vectorstofinal/millz-a10-simpit/public/img/aux-lts-first-light.jpg

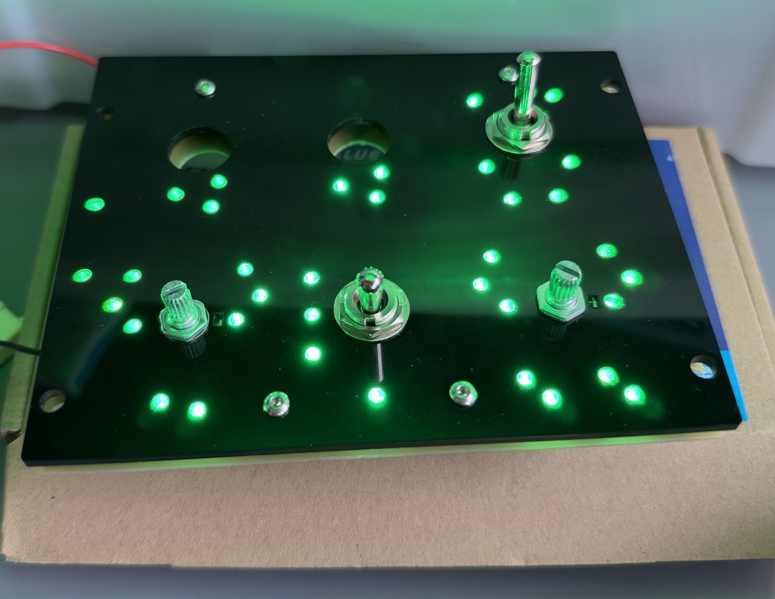
public/img/aux-lts-first-light.jpg
