vectorstofinal/millz-a10-simpit/public/img/aux-lts-lit-panel.jpg

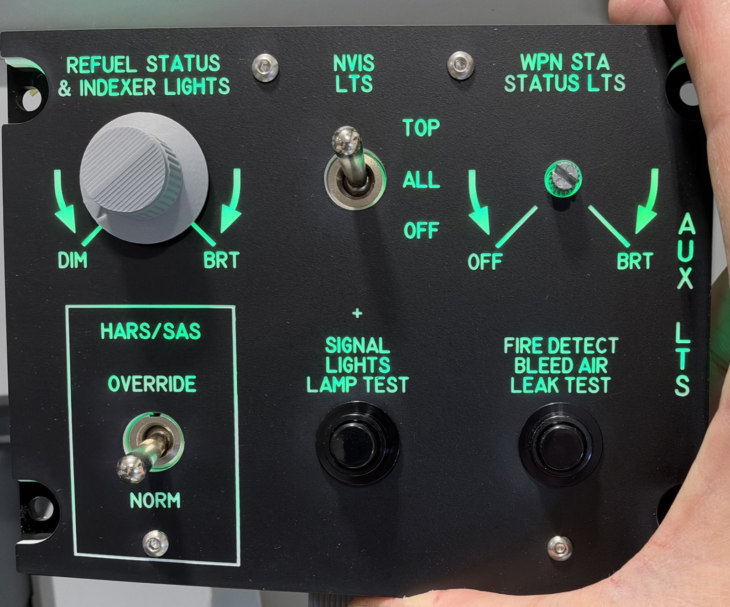
public/img/aux-lts-lit-panel.jpg
