vectorstofinal/millz-a10-simpit/src/pages/about.md

---
layout: ../layouts/Page.astro
title: About
eyebrow: The pit, the shop, the fine print
description: About the Millz A-10 SimPit build, plus credits and licensing.
---

I'm J. I run **millz**, a small maker shop with an aviation streak: CNC routing, laser cutting, 3D printing and small electronics. This site is the build log for my replica **A-10C Warthog** cockpit for DCS World.

## The shop

- **CNC router:** Onefinity Elite Foreman (Gen 2), 4x4 bed, Redline controller, 80 mm air-cooled spindle, VCarve Pro
- **Laser:** Thunder Laser Bolt Pro 36 (80 W RF CO2), LightBurn
- **3D printer:** Prusa XL, 0.4 mm nozzle, mostly PETG
- **CAD:** FreeCAD and OpenSCAD

More detail, and what each machine does in the build: [equipment](/equipment/).

## Licensing

- **My original work** (posts, settings, test results, board designs, STLs, OpenSCAD source, sketches) is dedicated to the public domain under [CC0 1.0](https://creativecommons.org/publicdomain/zero/1.0/). Use it however you like.
- **Panel files** are edits of The Warthog Project's free release. Their author says: *"I have no interest in claiming copyright on my own work… I am releasing these files to the public, do with them what you will."* I'm passing them on the same way, with credit.
- **Everything else** on the credits list belongs to its owners. I link to it rather than host it.

No warranty. Lasers, routers, mains power and ATX supplies can hurt you. Measure your own parts.

## Credits

- **[The Warthog Project](https://thewarthogproject.com):** the panel designs everything here starts from, and the best A-10C pit resource out there. [YouTube](https://www.youtube.com/channel/UCJq3cq9N6xYF0fAvTgpwoBg/).
- **FLIM / Vr-pits:** the cockpit structure plans (seat, consoles, glare shield). Paid plans, not redistributed here. See the [Vr-pits plans thread](https://forum.dcs.world/topic/123000-vrpitscom-cockpit-plans-for-sale) on the DCS forums.
- **[DCS-BIOS](https://github.com/DCS-Skunkworks/dcs-bios)** and **[Bort](https://github.com/DCS-Skunkworks/Bort)** by DCS-Skunkworks: how the pit talks to the sim.
- **Les Green:** printable A-10C parts on [GrabCAD](https://grabcad.com/les.green-2/models) ([forum thread](https://forum.dcs.world/topic/337352-miscellaneous-3d-files-a10c-parts)). Get them from him.
- **MS33558 font** by Derek Higgs (corrected 2020 by hsssonic). Freely available online; not hosted here.
- **[Houston Acrylic](https://houstonacrylic.com):** the acrylic in every panel.
- **[Eagle Dynamics](https://www.digitalcombatsimulator.com):** DCS World and the A-10C module. Cockpit textures are theirs and aren't hosted here.
