vectorstofinal/millz-a10-simpit/public/img/aux-lts-3d.png

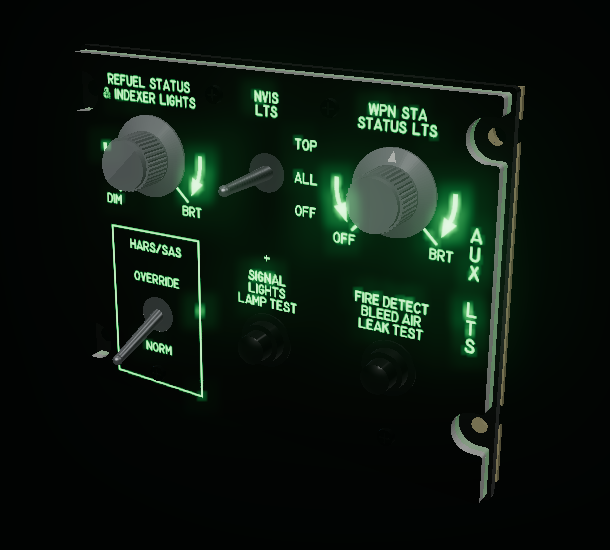
public/img/aux-lts-3d.png
