vectorstofinal/millz-a10-simpit/public/img/aux-lts-gnd-links.png

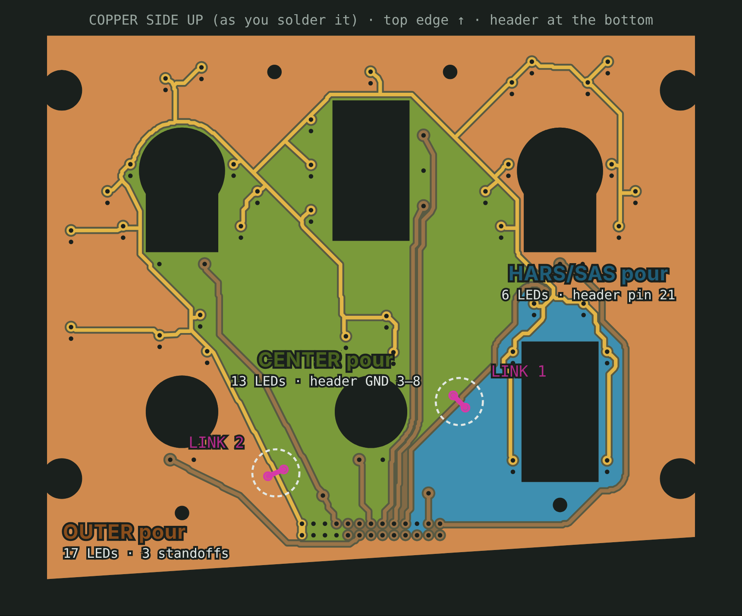
public/img/aux-lts-gnd-links.png
