vectorstofinal/millz-a10-simpit/public/img/aux-lts-gnd-staple.png

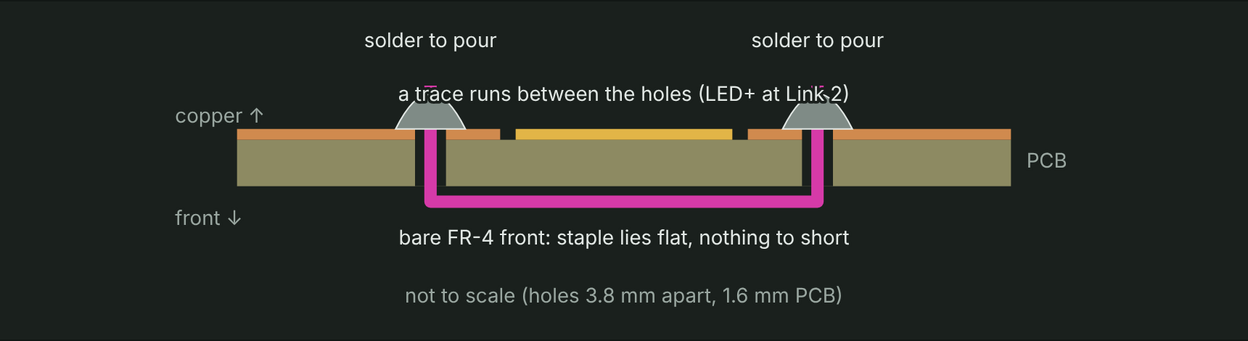
public/img/aux-lts-gnd-staple.png
