vectorstofinal/millz-a10-simpit/public/img/aux-lts-led-clearance.png

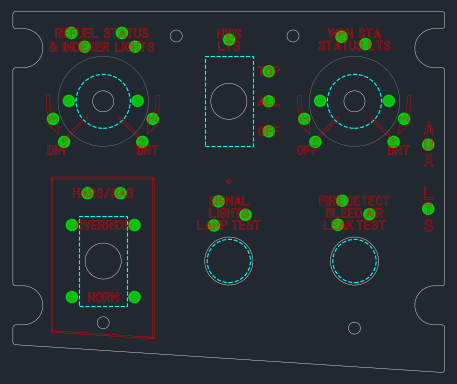
public/img/aux-lts-led-clearance.png
