vectorstofinal/millz-a10-simpit/public/img/aux-lts-led-seating.png

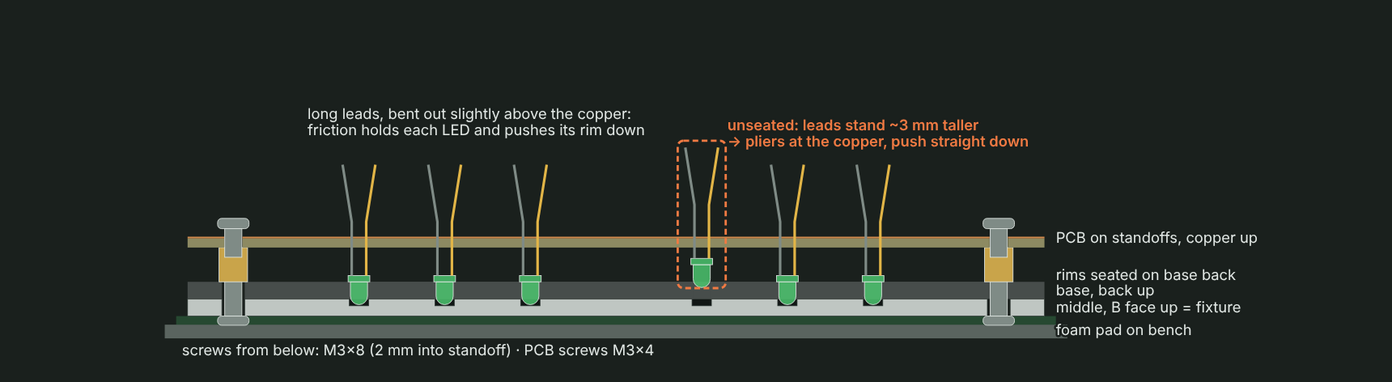
public/img/aux-lts-led-seating.png
