vectorstofinal/millz-a10-simpit/public/img/aux-lts-pcb-over-base.png

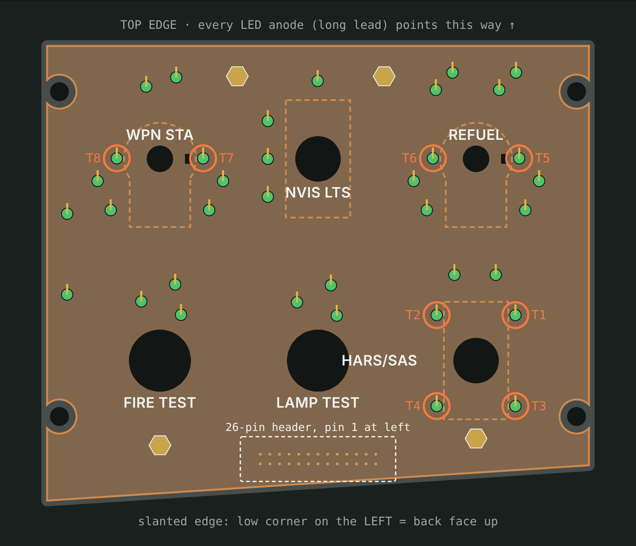
public/img/aux-lts-pcb-over-base.png
