vectorstofinal/millz-a10-simpit/public/img/aux-lts-pcb-v2-copper.png

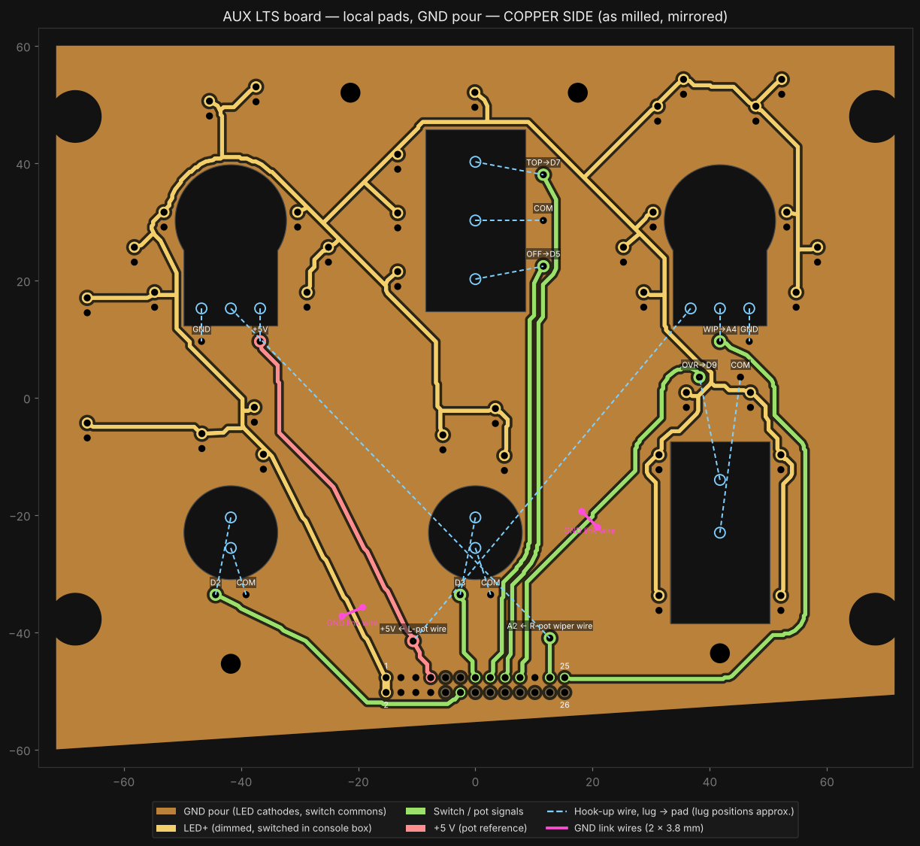
public/img/aux-lts-pcb-v2-copper.png
