vectorstofinal/millz-a10-simpit/public/img/aux-lts-pcb-v2-front.png

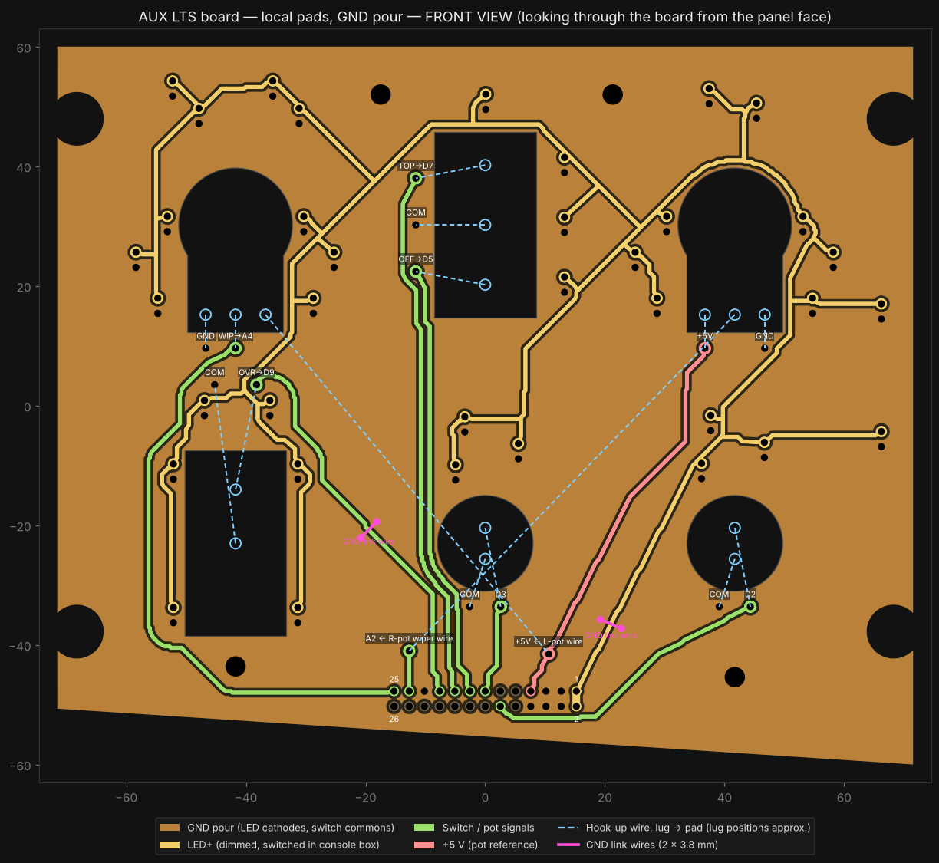
public/img/aux-lts-pcb-v2-front.png
