vectorstofinal/millz-a10-simpit/public/img/aux-lts-pcb-v2-vcarve-job.png

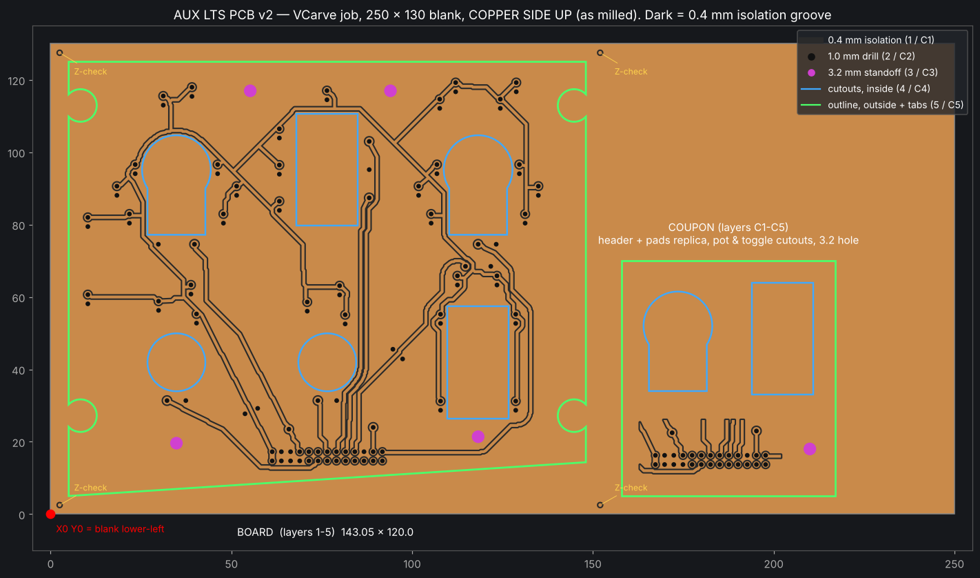
public/img/aux-lts-pcb-v2-vcarve-job.png
