vectorstofinal/millz-a10-simpit/public/img/aux-lts-stack-section.png

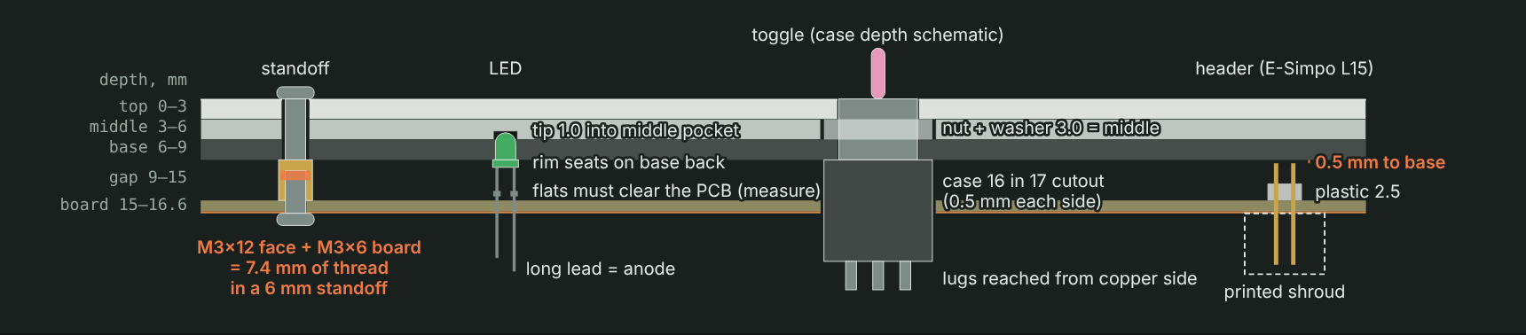
public/img/aux-lts-stack-section.png
