vectorstofinal/millz-a10-simpit/public/img/aux-lts-stacked-front.jpg

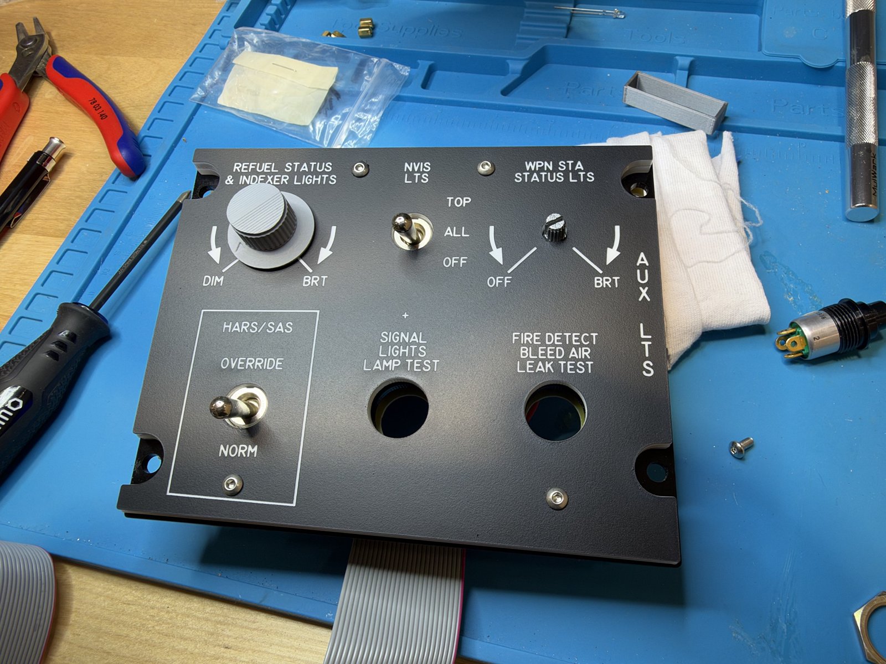
public/img/aux-lts-stacked-front.jpg
