vectorstofinal/millz-a10-simpit/public/img/aux-lts-terminals-back.jpg

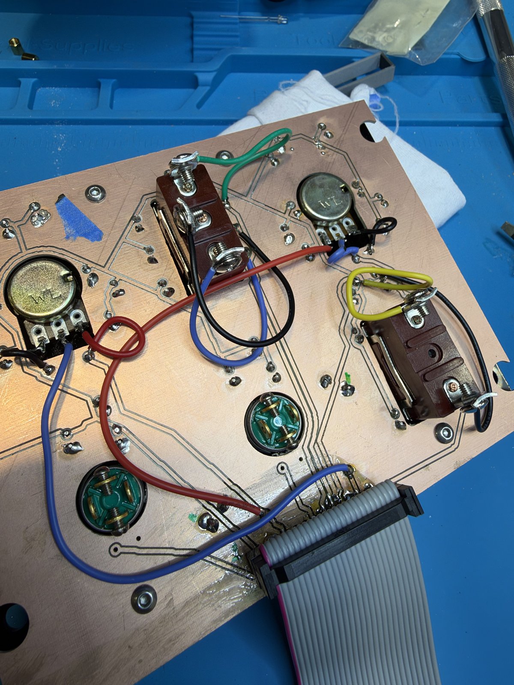
public/img/aux-lts-terminals-back.jpg
