vectorstofinal/millz-a10-simpit/public/img/aux-lts-top-preview.png

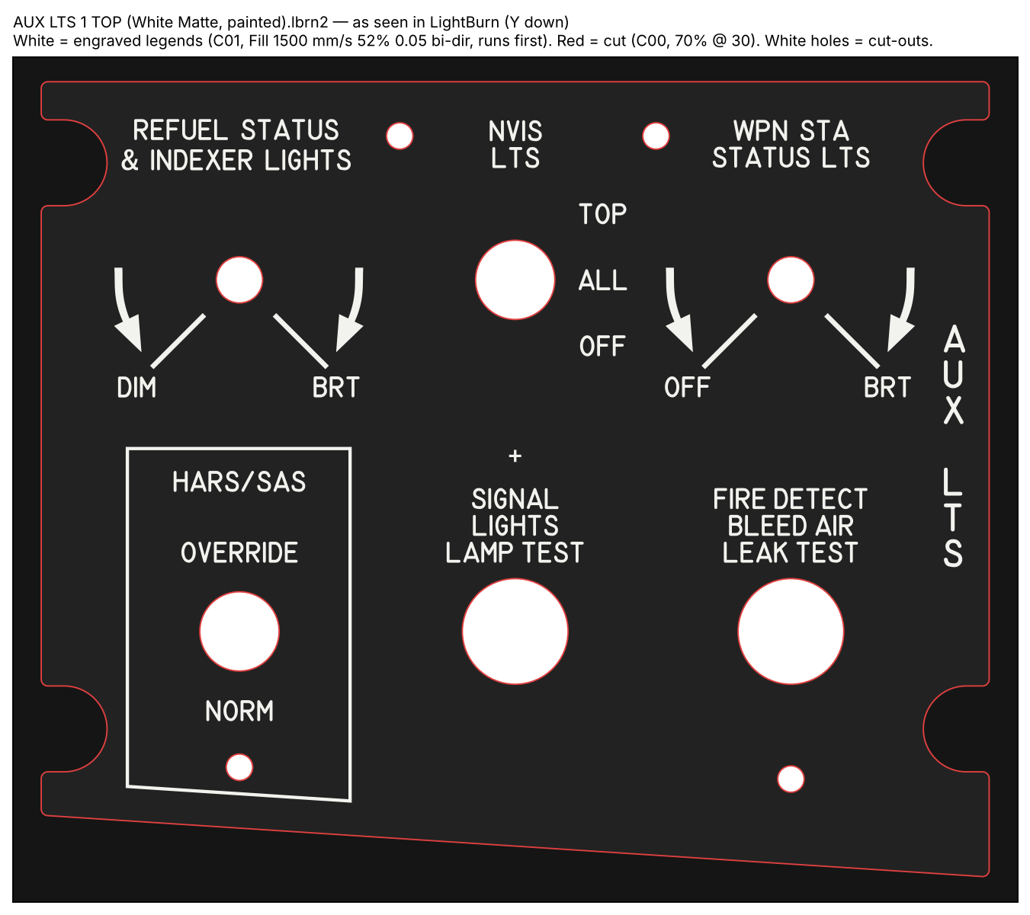
public/img/aux-lts-top-preview.png
