vectorstofinal/millz-a10-simpit/public/img/aux-lts-trimmed-back.jpg

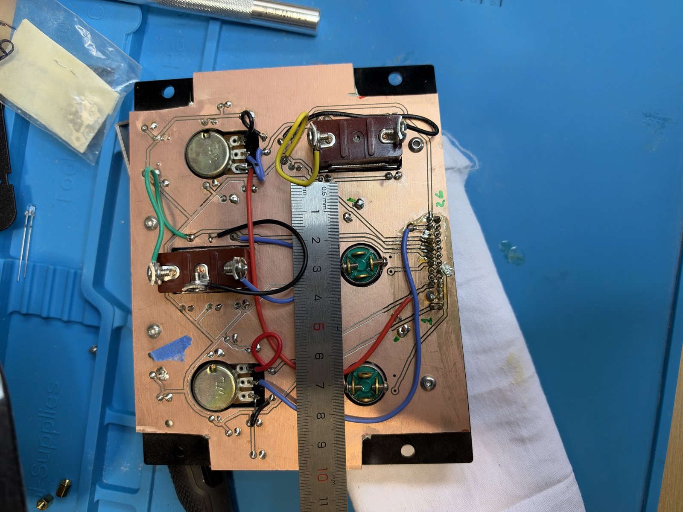
public/img/aux-lts-trimmed-back.jpg
