vectorstofinal/millz-a10-simpit/public/img/aux-lts-wired-back.jpg

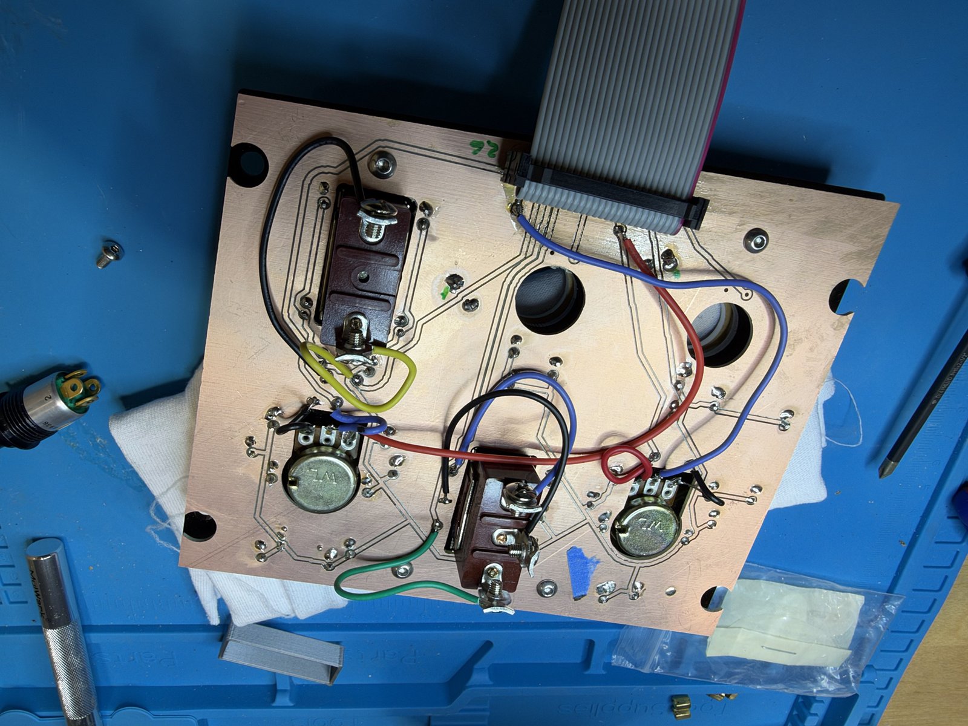
public/img/aux-lts-wired-back.jpg
