vectorstofinal/millz-a10-simpit/public/img/dimmer-knob-preview.png

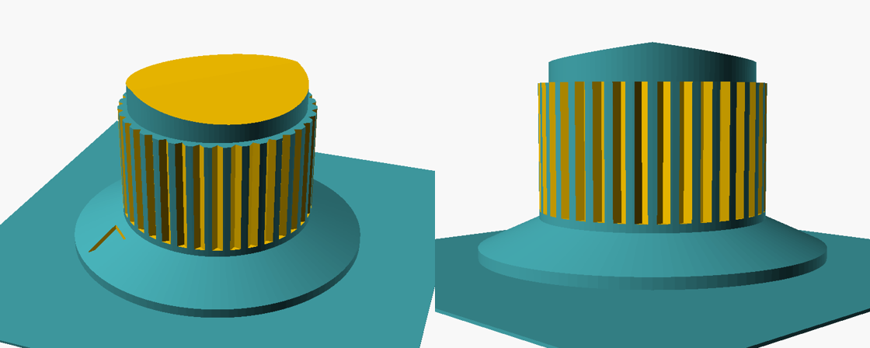
public/img/dimmer-knob-preview.png
