vectorstofinal/millz-a10-simpit/public/files/aux-lts-back-case/aux-lts-back-case-v2.stl

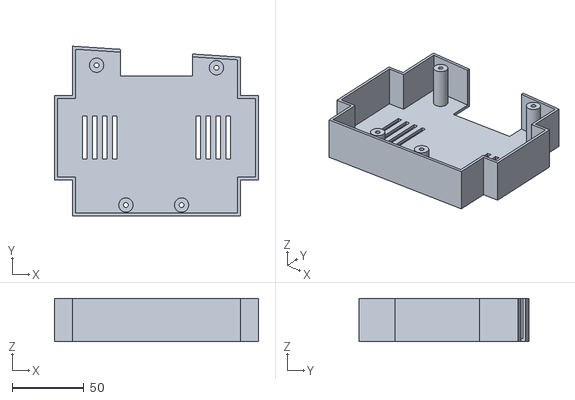
[picture p19: CAD file, 2026-11-14]
public/files/aux-lts-back-case/aux-lts-back-case-v2.stl
142.1 x 118.1 x 30.0
