vectorstofinal/millz-a10-simpit/public/files/aux-lts-panel/aux-lts-all-layers-edited.dxf

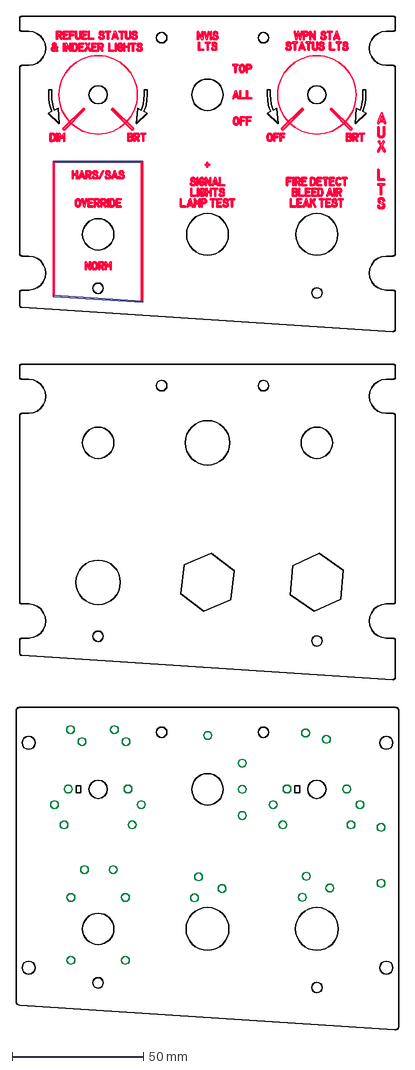
[picture p20: CAD file, 2026-11-11]
public/files/aux-lts-panel/aux-lts-all-layers-edited.dxf
146.1 x 386.7 mm
