vectorstofinal/millz-a10-simpit/public/files/aux-lts-pcb/header-pin-trim-gauge-8mm.stl

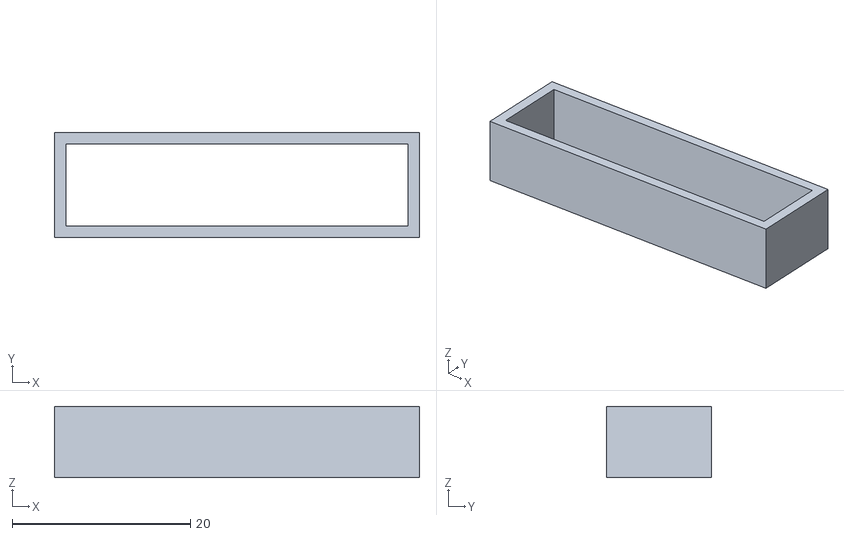
[picture p21: CAD file, 2026-11-13]
public/files/aux-lts-pcb/header-pin-trim-gauge-8mm.stl
41.0 x 11.8 x 8.00
