vectorstofinal/millz-a10-simpit/public/files/dimmer-knob/dimmer-knob-26mm.stl

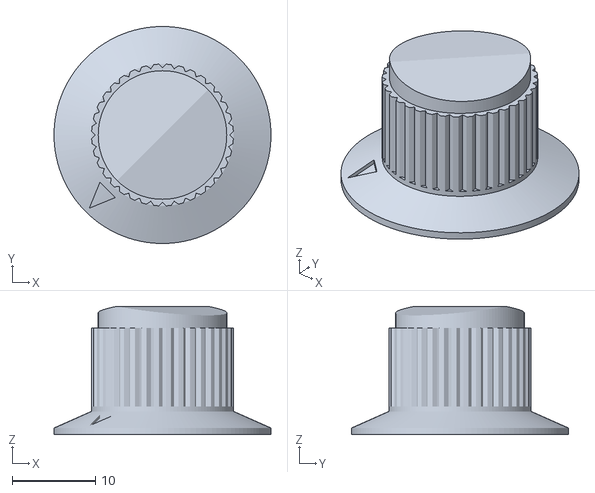
[picture p22: CAD file, 2026-11-11]
public/files/dimmer-knob/dimmer-knob-26mm.stl
26.0 x 26.0 x 15.4
