vectorstofinal/millz-a10-simpit/public/files/laser-tests/aux-lts-fit-test-strip.dxf

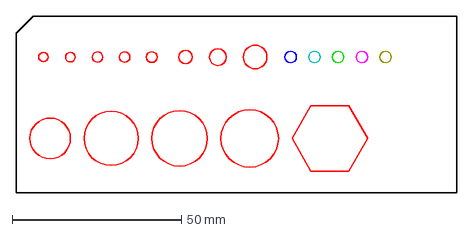
[picture p23: CAD file, 2026-11-11]
public/files/laser-tests/aux-lts-fit-test-strip.dxf
130.0 x 52.0 mm
