vectorstofinal/millz-a10-simpit/public/files/aux-lts-back-case/aux-lts-pcb-v2-trimmed-outline.dxf

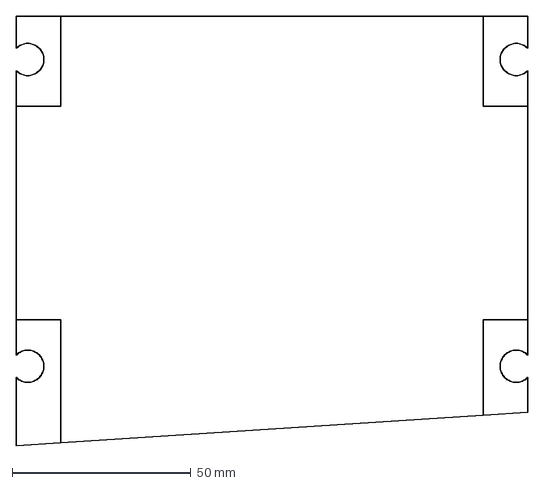
[picture p24: CAD file, 2026-11-14]
public/files/aux-lts-back-case/aux-lts-pcb-v2-trimmed-outline.dxf
143.1 x 120.0 mm
