vectorstofinal/millz-a10-simpit/public/files/aux-lts-panel/aux-lts-2-middle.dxf

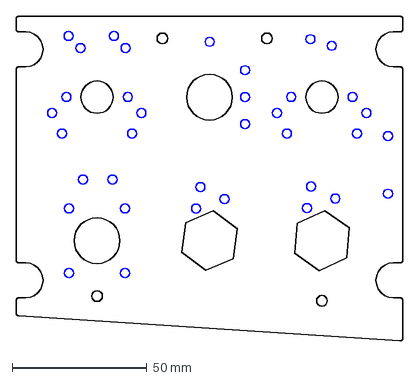
[picture p25: CAD file, 2026-11-11]
public/files/aux-lts-panel/aux-lts-2-middle.dxf
143.5 x 120.4 mm
