vectorstofinal/millz-a10-simpit/public/files/aux-lts-pcb/aux-lts-pcb-v2-vcarve-job-250x130.dxf

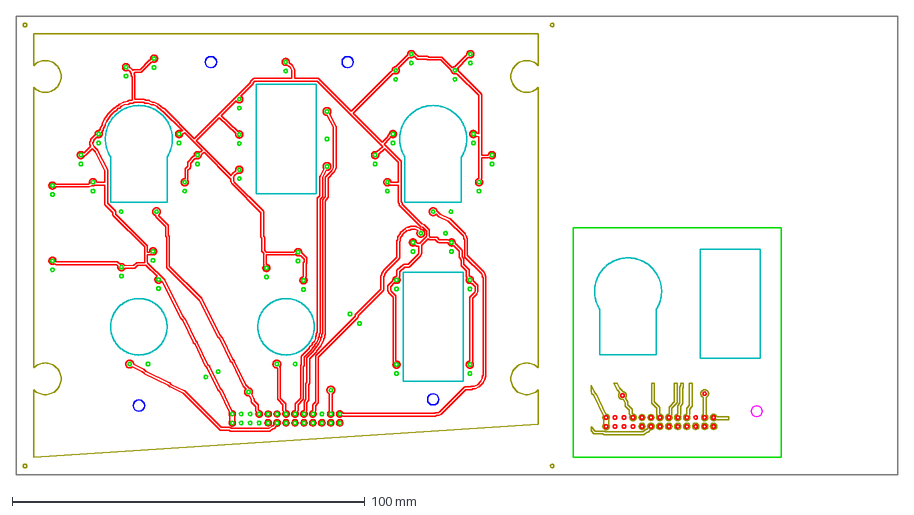
[picture p26: CAD file, 2026-11-11]
public/files/aux-lts-pcb/aux-lts-pcb-v2-vcarve-job-250x130.dxf
250.0 x 130.0 mm
