vectorstofinal/millz-a10-simpit/public/files/aux-lts-panel/aux-lts-3-base.dxf

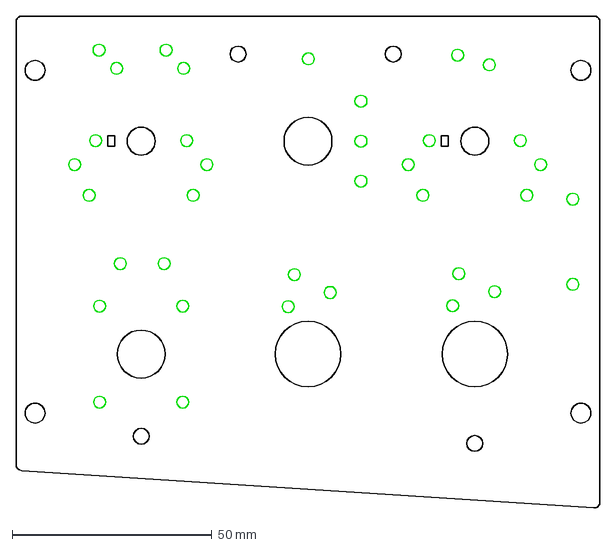
[picture p27: CAD file, 2026-11-11]
public/files/aux-lts-panel/aux-lts-3-base.dxf
146.1 x 123.0 mm
