vectorstofinal/millz-a10-simpit/public/files/aux-lts-pcb/aux-lts-pcb-v2-cnc-back-view.dxf

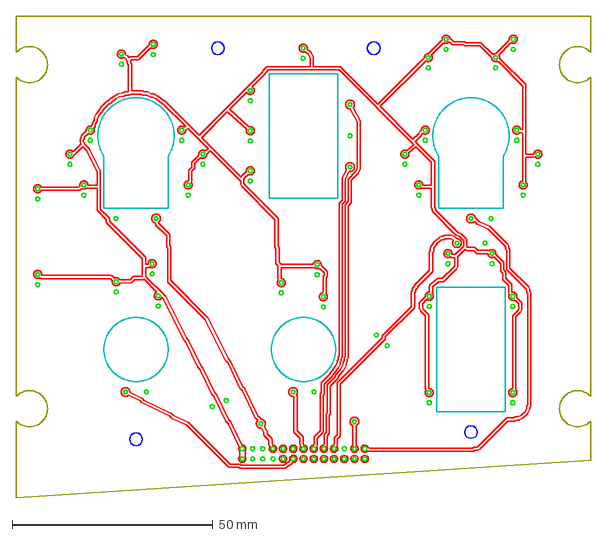
[picture p28: CAD file, 2026-11-11]
public/files/aux-lts-pcb/aux-lts-pcb-v2-cnc-back-view.dxf
143.1 x 120.0 mm
