vectorstofinal/millz-a10-simpit/public/files/aux-lts-panel/aux-lts-1-top.dxf

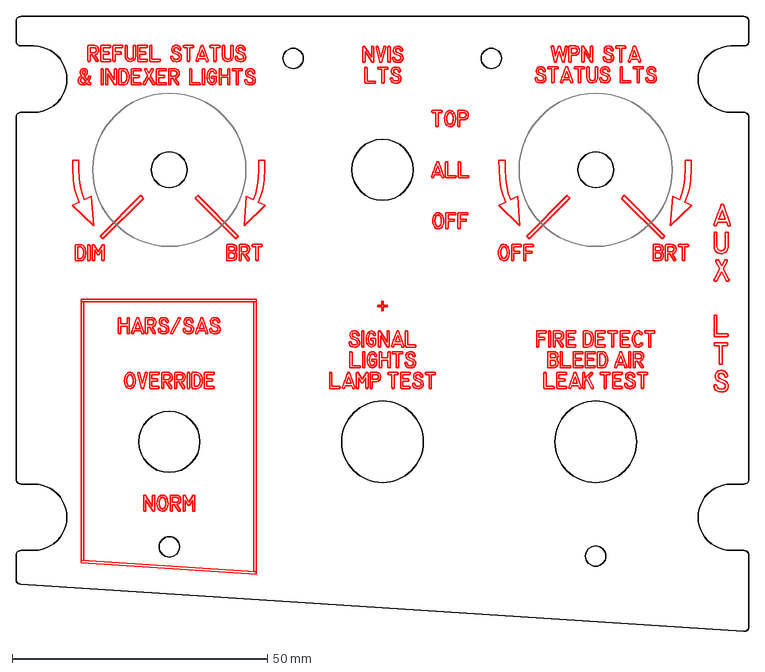
[picture p29: CAD file, 2026-11-11]
public/files/aux-lts-panel/aux-lts-1-top.dxf
143.5 x 120.4 mm
