vectorstofinal/millz-a10-simpit/public/files/aux-lts-pcb/idc-2x13-keyed-shroud.stl

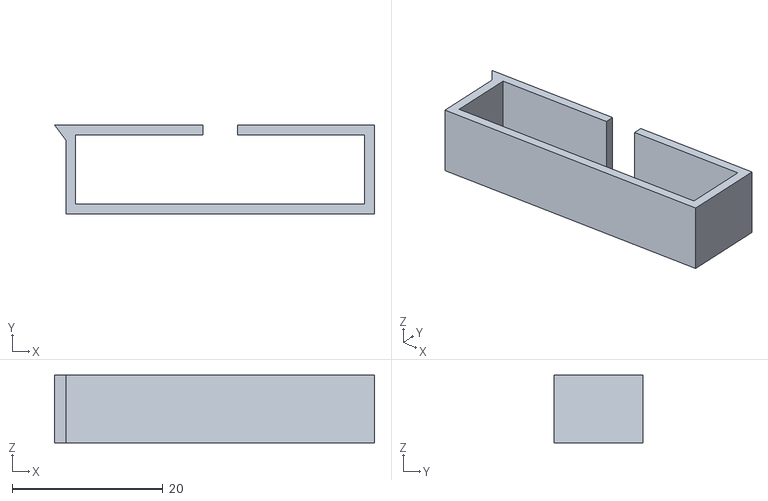
[picture p30: CAD file, 2026-11-11]
public/files/aux-lts-pcb/idc-2x13-keyed-shroud.stl
42.5 x 11.8 x 9.00
