vectorstofinal/millz-a10-simpit/public/img/aux-lts-bench-rig-wiring.png

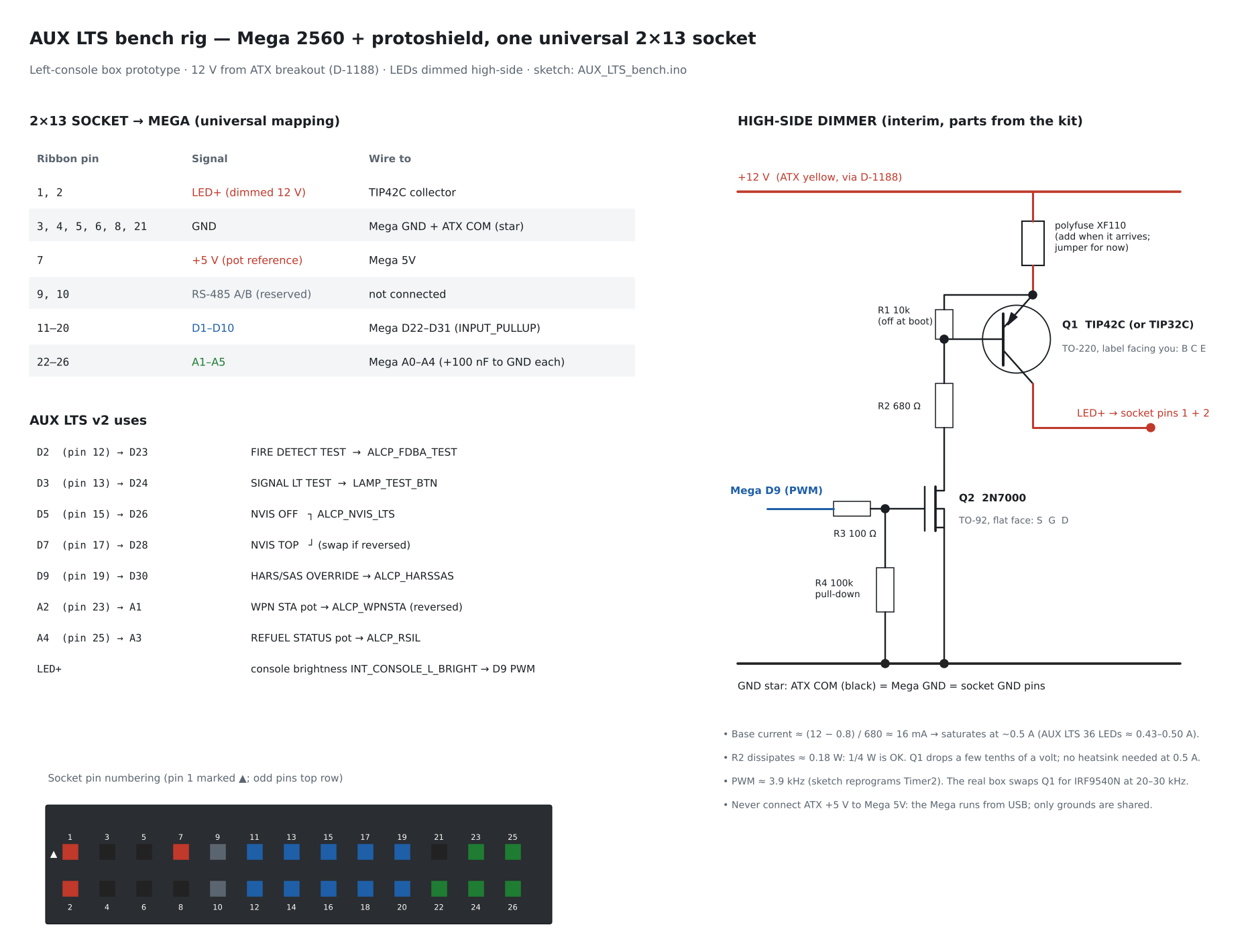
public/img/aux-lts-bench-rig-wiring.png
