vectorstofinal/millz-a10-simpit/public/img/paint-banding-test-legend.png

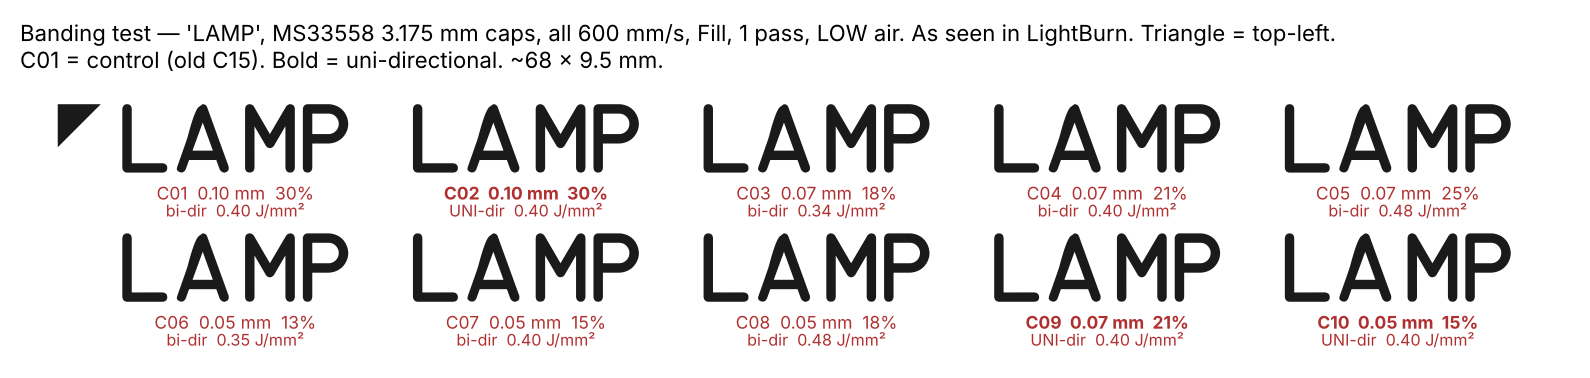
public/img/paint-banding-test-legend.png
