vectorstofinal/millz-a10-simpit/public/img/paint-lettering-test-legend.png

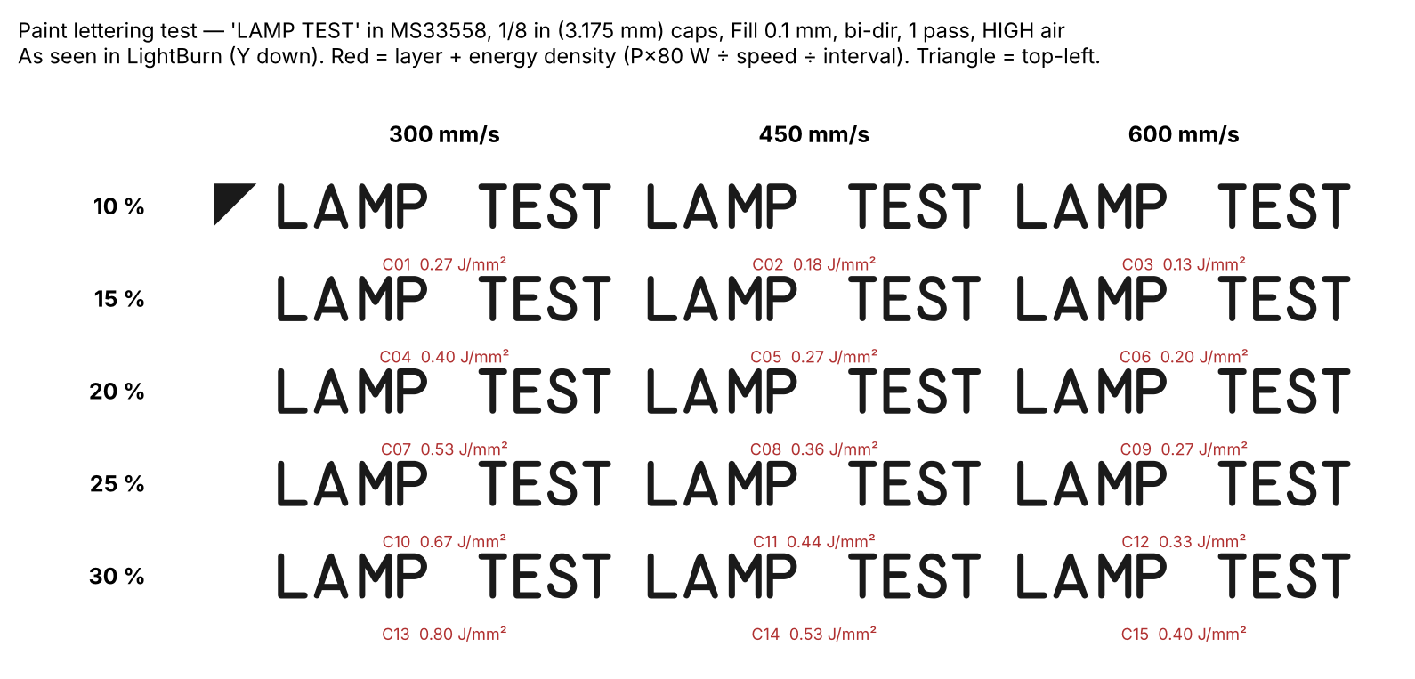
public/img/paint-lettering-test-legend.png
