vectorstofinal/millz-a10-simpit/public/files/aux-lts-back-case/aux-lts-pcb-corner-trim-template.pdf

## AUX LTS PCB v2: corner trim template (1:1, copper side up, header toward you)

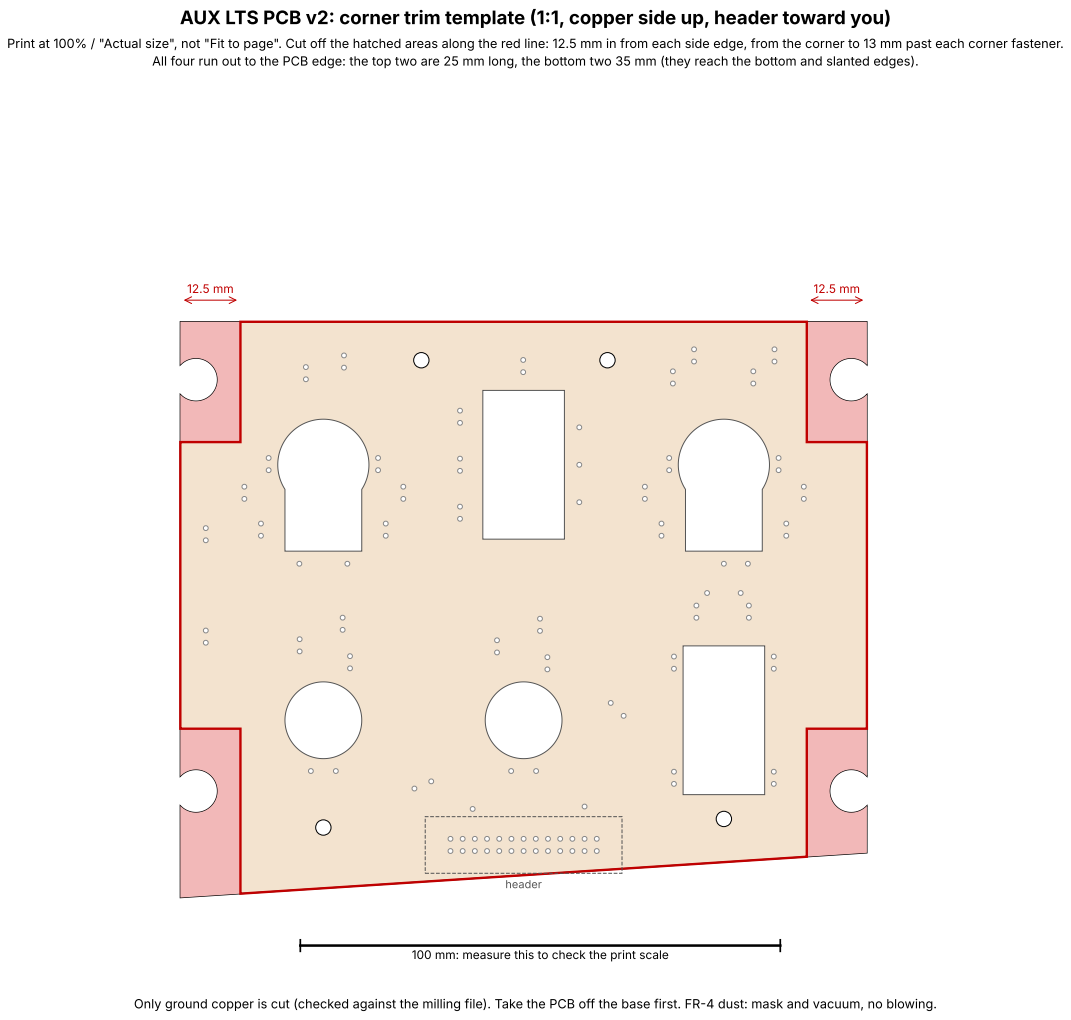
[picture p34: page 1]
header

Print at 100% / "Actual size", not "Fit to page". Cut off the hatched areas along the red line: 12.5 mm in from each side edge, from the corner to 13 mm past each corner fastener.

All four run out to the PCB edge: the top two are 25 mm long, the bottom two 35 mm (they reach the bottom and slanted edges).

100 mm: measure this to check the print scale

Only ground copper is cut (checked against the milling file). Take the PCB off the base first. FR-4 dust: mask and vacuum, no blowing.
