vectorstofinal/millz-a10-simpit/(commit log)

2026-11-11 Initial commit: Millz A-10 SimPit build log site
    Astro static site served by nginx on fly.io, with a GitHub Actions
    workflow that deploys on every push to main.
    Claude-Session: https://claude.ai/code/session_01Jiw7tsgPA7dnNpVz3PHaMJ
    [aux-lts-1-top.dxf, aux-lts-2-middle.dxf, aux-lts-3-base.dxf, aux-lts-all-layers-edited.dxf, aux-lts-fit-test-strip.dxf, aux-lts-pcb-v2-cnc-back-view.dxf, aux-lts-pcb-v2-vcarve-job-250x130.dxf, dimmer-knob-26mm.stl]
2026-11-11 Post: AUX LTS PCB milled; add Equipment page
    - New post: isolation recipe that stopped bit breakage, coupon results,
    standoff screw-length trap, hanging-LED loading method, with figures
    - New /equipment/ page (Onefinity + Redline, Bolt Pro 36, Aurora Lite,
    Prusa XL, software, bench, materials) and nav link
    - Settings: PCB milling table updated to the proven values
    - Home status tile: AUX LTS PCB milled
    Claude-Session: https://claude.ai/code/session_01Jiw7ttHhgJ9RNUNr58oLYW
2026-11-13 Post: AUX LTS first light; header pin trim gauge download
    - New post: ground link staples, header trim to 8 mm with a printed
    gauge, no-mask soldering lessons, 36 LEDs at 0.432 A, next-PCB rules
    - Figures: ground areas + staple side view
    - Files: header pin trim gauge STL (with viewer)
    - Home status tile: AUX LTS PCB first light
    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
    [header-pin-trim-gauge-8mm.stl]
2026-11-14 Post: AUX LTS wired, tested and stacked (J's photos)
    - New post: hook-up wiring, toggle ring-out and the HARS firmware fix,
    pot readings, ribbon-end testing, painted top layer, next steps
    - Two photos from J (resized, EXIF stripped)
    - Home status: panel stacked; PCB wired and tested
    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
2026-11-14 AUX LTS stacked post: lit-panel photo as hero; knob layer height 0.1 mm
    - J's backlit photo through the full stack, with notes on light leaks
    at the switch holes and edges, and hot spots
    - Dimmer knob print settings: 0.1 mm layers (post + settings page)
    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
2026-11-14 Use American spelling across posts, the 3D model page and the ground-links figure
    center/centered, colors, gray, fiberglass, burned. The CENTRE pour label in
    aux-lts-gnd-links.png now reads CENTER.
    Claude-Session: https://claude.ai/code/session_01Jiw7tv7Jf6RjMT1MDWdYEw
2026-11-14 AUX LTS panel page: DCS-BIOS code section; screw-terminal toggles
    - Panel's DCS-BIOS lines (socket macros, six controls, names checked
    against the A-10C module); backlight noted as local box dimming
    - Toggles on screw terminals (pushbuttons where hardware allows):
    parts list and disassembly/reassembly steps updated
    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
2026-11-14 AUX LTS: terminals from the bench photo (panel page + 3D model)
    Panel page: new Terminals and wire colors section with photo; NVIS has
    three screw terminals, HARS/SAS two (no center), MS25089-3G is a
    two-circuit switch wired on its normally-open (opposite) pair.
    3D model: toggle screw terminals and lugs, pushbutton rear with four
    terminals, wire colors as built.
    Claude-Session: https://claude.ai/code/session_01Jiw7tt5LXksgJCaLKEWZqW
2026-11-14 Post: AUX LTS corners trimmed and back case; back case + trim files
    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
    [aux-lts-back-case-v2.stl, aux-lts-pcb-v2-trimmed-outline.dxf, panel_back_case.scad]
